IDSCETHZurich/klask_hardware/docs/tutorials/00-overview.md

# Tutorial Overview

There are several tutorials available to help you get started with KLASK Hardware. These tutorials cover various aspects of working with the hardware, from setting up your environment to advanced usage scenarios.

## Available Tutorials

- [Hardware Assembly Guide](01-hardware-assembly.md): Step-by-step instructions to assemble the KLASK hardware components.
- [Runtime Startup](02-runtime-startup.md): Guide to starting up and shutting down the KLASK hardware safely.
- [Development Setup](03-dev-setup.md): Instructions for setting up your development environment for working with KLASK Hardware.
