IDSCETHZurich/klask_hardware/(list of files, cad)

Other CAD files:
hardware/cad/assemblies/board_frame.SLDASM
hardware/cad/third_party_parts/assemblies/mini v gantry kit.SLDASM
hardware/cad/assemblies/frame_support.SLDASM
hardware/cad/klask_game_board/KlaskGame.SLDASM
hardware/cad/third_party_parts/assemblies/idler.SLDASM
hardware/cad/assemblies/global_assembly.SLDASM
hardware/cad/assemblies/gantry.SLDASM
hardware/cad/assemblies/bridge.SLDASM
hardware/cad/assemblies/controller_base_passive.SLDASM
hardware/cad/assemblies/limit_switch.SLDASM
hardware/cad/assemblies/duality_connector.SLDASM
hardware/cad/assemblies/foot_assembly.SLDASM
hardware/cad/assemblies/belt_attachment.SLDASM
hardware/cad/assemblies/motor_assembly.SLDASM
hardware/cad/assemblies/camera_mount.SLDASM
hardware/cad/assemblies/gantry_frame.SLDASM
hardware/cad/assemblies/idler_assembly.SLDASM
hardware/cad/assemblies/stepper_mount.SLDASM
hardware/cad/klask_game_board/KlaskScoreCoin.SLDPRT
hardware/cad/parts/goal_disk_flat.SLDPRT
hardware/cad/third_party_parts/parts/bearings/Ball Bearing 5 x 16 x 5.SLDPRT
hardware/cad/third_party_parts/parts/brackets/Black Angle Corner Connector.SLDPRT
hardware/cad/third_party_parts/parts/electronics/M8325s_S1.SLDPRT
hardware/cad/third_party_parts/parts/mini_v_gantry_kit/Precision Shim 8 x 5 x 1.SLDPRT
hardware/cad/third_party_parts/parts/plates/Joining Plate Cross.step.SLDPRT
hardware/cad/third_party_parts/parts/profiles/V-Slot-20x20-Cover.SLDPRT
hardware/cad/third_party_parts/parts/pulleys/Smooth Idler Pulley Wheel.step.SLDPRT
hardware/cad/third_party_parts/parts/shims_spacers/Aluminum Spacer 9mm.step.SLDPRT
hardware/cad/parts/board_corner.SLDPRT
hardware/cad/third_party_parts/parts/brackets/L Bracket Single.SLDPRT
hardware/cad/third_party_parts/parts/electronics/Nanlite_compac_24B.SLDPRT
hardware/cad/third_party_parts/parts/mini_v_gantry_kit/Ball Bearing 5 x 10 x 4.2.step.SLDPRT
hardware/cad/third_party_parts/parts/plates/Joining Strip Plate 2 Hole.step.SLDPRT
hardware/cad/third_party_parts/parts/profiles/V-Slot 20x20 Linear Rail.SLDPRT
hardware/cad/third_party_parts/parts/pulleys/GT2 Timing Pulley 20 Tooth.step.SLDPRT
hardware/cad/third_party_parts/parts/shims_spacers/Aluminum Spacer 6mm.SLDPRT
hardware/cad/klask_game_board/KlaskControllerBase.SLDPRT
hardware/cad/parts/goal_disk_sphere.SLDPRT
hardware/cad/third_party_parts/parts/brackets/Inside Hidden Corner Bracket.SLDPRT
hardware/cad/third_party_parts/parts/electronics/nema 17 42-34.SLDPRT
hardware/cad/third_party_parts/parts/mini_v_gantry_kit/Mini V Wheel Plate.SLDPRT
hardware/cad/third_party_parts/parts/plates/Idler Pulley Plate.SLDPRT
hardware/cad/third_party_parts/parts/shims_spacers/Aluminum Spacer 3mm.step.SLDPRT
hardware/cad/klask_game_board/KlaskBall.SLDPRT
hardware/cad/parts/frame_centering_bridge.SLDPRT
hardware/cad/third_party_parts/parts/brackets/End Cap.step.SLDPRT
hardware/cad/third_party_parts/parts/electronics/camera.SLDPRT
hardware/cad/third_party_parts/parts/plates/Motor Mount Plate Nema 17.step.SLDPRT
hardware/cad/third_party_parts/parts/shims_spacers/Precision Shim 10 x 5 x 1.step.SLDPRT
hardware/cad/klask_game_board/KlaskBiscuit.SLDPRT
hardware/cad/parts/frame_support_center_plate.SLDPRT
hardware/cad/third_party_parts/parts/brackets/Cube Corner Connector.step.SLDPRT
hardware/cad/third_party_parts/parts/electronics/WE_LimitSwitch_463093370402.SLDPRT
hardware/cad/klask_game_board/Klask.SLDPRT
hardware/cad/parts/frame_support_groundplate.SLDPRT
hardware/cad/third_party_parts/parts/mini_v_gantry_kit/Eccentric Spacer 6mm v1.SLDPRT
hardware/cad/klask_game_board/KlaskControllerTop.SLDPRT
hardware/cad/parts/frame_support_mounting.SLDPRT
hardware/cad/third_party_parts/parts/mini_v_gantry_kit/Delrin Mini V Wheel.SLDPRT
hardware/cad/parts/peg_holder_v3.SLDPRT
hardware/cad/parts/limit_switch_mount.SLDPRT
hardware/cad/parts/limit_switch_cover.SLDPRT
hardware/cad/parts/belt_adaptive.SLDPRT
hardware/cad/parts/Motor_enclosure_bottom.SLDPRT
hardware/cad/parts/Connector.SLDPRT
hardware/cad/parts/Shaft.SLDPRT
hardware/cad/parts/Motor_enclosure_top.SLDPRT
hardware/cad/parts/belt.SLDPRT
hardware/cad/parts/rubber_feet.SLDPRT
hardware/cad/parts/pipe_clamp.SLDPRT
hardware/cad/parts/peg_holder.SLDPRT
hardware/cad/third_party_parts/parts/mini_v_gantry_kit/Low Profile Screw M5 v1.SLDPRT
hardware/cad/third_party_parts/parts/mini_v_gantry_kit/Nylon Insert Lock Nut M5.SLDPRT
hardware/cad/third_party_parts/parts/nuts/BN_629_1241613_nut_M3.sldprt
hardware/cad/third_party_parts/parts/nuts/BN_629_1348418_Nut_M2.sldprt
hardware/cad/third_party_parts/parts/nuts/Double Tee Nut.SLDPRT
hardware/cad/third_party_parts/parts/nuts/Hex_Nut_M5.sldprt
hardware/cad/third_party_parts/parts/nuts/Tee Nut.step.SLDPRT
hardware/cad/third_party_parts/parts/screws/BN_4719_1099876_M2x12.sldprt
hardware/cad/third_party_parts/parts/screws/BN_4719_1100114_M3x25.sldprt
hardware/cad/third_party_parts/parts/screws/BN_4719_1713736_M5x18.sldprt
hardware/cad/third_party_parts/parts/screws/BN_610_1420607_M2x12.sldprt
hardware/cad/third_party_parts/parts/screws/BN_610_3092533_M5x30.sldprt
hardware/cad/third_party_parts/parts/screws/Countersunk_Screw_M3x14.sldprt
hardware/cad/third_party_parts/parts/screws/Low Profile Screw M5.step.SLDPRT
hardware/cad/third_party_parts/parts/screws/Low Profile Screw M5x25.SLDPRT
hardware/cad/third_party_parts/parts/screws/Low Profile Screw M5x30.SLDPRT
hardware/cad/third_party_parts/parts/screws/Low Profile Screw M5x35.SLDPRT
hardware/cad/third_party_parts/parts/screws/Self Tapping Screw.step.SLDPRT
hardware/cad/third_party_parts/parts/screws/Zyl-Schr-M4x20.sldprt
hardware/cad/third_party_parts/parts/screws/Zyl-Schr-M5x14.SLDPRT
hardware/cad/third_party_parts/parts/screws/Zyl-Schr-M5x20.SLDPRT
hardware/cad/third_party_parts/parts/shims_spacers/Slot Washer 15 x 5 x 2.step.SLDPRT
