IDSCETHZurich/klask_hardware/(commit log)

2025-12-03 chore(estimator): workspace mounted in container for persistence
2025-12-03 feat(motor): motor_commander package created
2025-12-05 feat(motor): motor node migrated
2025-12-05 feat(motor): launch file improved
2025-12-05 docs: motor launch command example added
2025-12-05 bug(motor): motor launch file condition bug fixed
    [motors_launch.py]
2025-12-05 chore(estimator): Kalman filter class and helper functions refactored by claude
2025-12-05 feat(estimator): update rate of image throttled
2025-12-06 chore(motor): code cleanup by claude
2025-12-08 feat(estimator): flood fill for board corner detection added
2025-12-08 feat(estimator): rotated rectangular board detection added
2025-12-08 feat(estimator): boarder segmentation started
2025-12-09 chore(camera): camera node formatted and old print functionallity readded
2025-12-09 feat(camera): boarder segment mask finished
2025-12-09 feat(camera): line seeded flood fill of boarder segments added
2025-12-09 feat(camera): segment transformation started
2025-12-10 feat(camera): segment rotation and debug image loading added
2025-12-10 feat(camera): boarder point detection and line fitting finished
2025-12-10 chore(camera): methods refactored for frame_process call
2025-12-10 chore(camera): debug functionality moved to own file
2025-12-11 chore(camera): unused methods removed and static computation data refactored
2025-12-11 feat(camera): add image display functionality with FPS overlay
2025-12-11 feat(camera): enhance border detection with smoothing and update debug display functions
2025-12-11 feat(camera): implement one-shot timer for profiling and update stats printing
2025-12-11 refactor(camera): improve perspective transform handling and simplify width/height calculations
2025-12-11 feat(camera): implement outlier detection for border tracking
2025-12-11 feat(camera): add goal detection logic and enhance debug visualization for goal positions
2025-12-12 chore(CAD): repo prepared for CAD files
2025-12-12 chore(camera): removed unused files and small cleanup
2025-12-13 feat(state): updated state estimator to publish proper board state
2025-12-14 feat(state): update state representation to use UInt64 and add BoardState class for goal tracking
2025-12-14 feat(camera): moved node configuration to ros parameters and added config guide
2025-12-14 chore(camera): streamline camera node parameters and improve documentation clarity
2025-12-14 feat(camera): enhance camera node parameters and improve calibration file handling
2025-12-14 feat(image_viewer): add parameter for board image topic
2025-12-16 feat(cad): game board and frame added
    [Klask.SLDPRT, KlaskBall.SLDPRT, KlaskBiscuit.SLDPRT, KlaskControllerBase.SLDPRT, KlaskControllerTop.SLDPRT, KlaskGame.SLDASM, KlaskScoreCoin.SLDPRT, V-Slot 20x20 Linear Rail.SLDPRT]
2025-12-16 feat(cad): gantry_frame and bridge assembly files added
    [V-Slot 20x20 Linear Rail.SLDPRT, bridge.SLDASM, gantry_frame.SLDASM, global_assembly.SLDASM]
2025-12-16 chore(motor): motor controller package renamed to match convention
2025-12-16 feat(odrive): update state subscription and callback to use new State message format
2025-12-17 bug(motor): motor message QoS corrected and shutdown sequence improved
    [player.cpp]
2025-12-17 feat(motor): refactor player handling to distinguish between left and right players
2025-12-17 feat(motor): add teleop twist keyboard package to Dockerfile
2025-12-17 feat(motor): add teleop launch configuration for player control
2025-12-17 feat(motor): enhance launch configurations and add start_commander parameter for motor commander control
2025-12-17 fix(player): improve synchronization checks in is_synchronized method
    [player.cpp]
2025-12-22 feat(config): update camera node parameters for improved tracking accuracy
2025-12-22 feat(motor): add xterm support for teleop twist keyboard and update default player configuration
2025-12-22 refactor(motor): motor commander refactored to match the latest version
2025-12-22 feat(motor): Enhance motor controller functionality with new services and action for peg homing
2025-12-22 bug(motor): boundary check corrected
    [open_loop_controller.hpp, player.cpp]
2025-12-28 chore: bridge migration started
    [Aluminum Spacer 6mm.SLDPRT, Aluminum Spacer 6mm.step, Ball Bearing 5 x 10 x 4.2.step.SLDPRT, Delrin Mini V Wheel.SLDPRT, Eccentric Spacer 6mm v1.SLDPRT, Low Profile Screw M5 v1.SLDPRT, Mini V Wheel Plate.SLDPRT, Nylon Insert Lock Nut M5.SLDPRT]
2025-12-29 chore: bridge migration finished
    [Aluminum Spacer 3mm.step.SLDPRT, Aluminum Spacer 6mm.SLDPRT, Aluminum Spacer 6mm.step, Aluminum Spacer 9mm.step.SLDPRT, Ball Bearing 5 x 16 x 5.SLDPRT, Black Angle Corner Connector.SLDPRT, Double Tee Nut.SLDPRT, End Cap.step.SLDPRT]
2025-12-29 chore: gantry frame migrated
    [Cube Corner Connector.step.SLDPRT, GT2 Timing Pulley 20 Tooth.step.SLDPRT, Idler Pulley Plate.SLDPRT, Inside Hidden Corner Bracket.SLDPRT, Joining Strip Plate 2 Hole.step.SLDPRT, Motor Mount Plate Nema 17.step.SLDPRT, V-Slot 20x20 Linear Rail.SLDPRT, belt.SLDPRT]
2025-12-29 chore: gantry migration finished
    [V-Slot 20x20 Linear Rail.SLDPRT, belt_adaptive.SLDPRT, board_frame.SLDASM, duality_connector.SLDASM, gantry.SLDASM, global_assembly.SLDASM]
2025-12-30 chore: motors and peg holder updated
    [Connector.SLDPRT, M8325s_S1.SLDPRT, Motor_enclosure_bottom.SLDPRT, Motor_enclosure_top.SLDPRT, Shaft.SLDPRT, bridge.SLDASM, controller_base_passive.SLDASM, gantry.SLDASM]
2025-12-31 feat(controller): migrate open loop controller parameters to YAML configuration and update parameter handling
    [open_loop_controller_params.yaml]
2025-12-31 feat(motor): migrate motor commander and ODrive parameters to YAML configuration and update parameter handling
    [motor_commander_params.yaml, odrive_controller_params.yaml]
2025-12-31 feat(controller): migrate player configuration to use PlayerSide enum and handle sides more generic
    [motor_commander_params.yaml]
2025-12-31 feat(state_estimator): implement pixel to engineering units conversion for state estimate
    [open_loop_controller_params.yaml]
2025-12-31 chore: file formatted
    [open_loop_controller_params.yaml]
2026-01-01 chore: limit switch mount added
    [WE_LimitSwitch_463093370402.SLDPRT, gantry.SLDASM, gantry_frame.SLDASM, limit_switch.SLDASM, limit_switch_cover.SLDPRT, limit_switch_mount.SLDPRT]
2026-01-01 chore: mirrored limit switch added
    [gantry.SLDASM, global_assembly.SLDASM, limit_switch.SLDASM, limit_switch_cover.SLDPRT, limit_switch_mount.SLDPRT]
2026-01-02 chore: frame mount added
    [board_frame.SLDASM, frame_centering_bridge.SLDPRT, frame_support.SLDASM, frame_support_center_plate.SLDPRT, frame_support_groundplate.SLDPRT, frame_support_mounting.SLDPRT, gantry.SLDASM, global_assembly.SLDASM]
2026-01-02 chore: camera mount added
    [Connector.SLDPRT, Motor_enclosure_bottom.SLDPRT, Motor_enclosure_top.SLDPRT, Nanlite_compac_24B.SLDPRT, V-Slot-20x20-Cover.SLDPRT, camera.SLDPRT, camera_mount.SLDASM, frame_centering_bridge.SLDPRT]
2026-01-02 feat: new peg holder designed
    [board_frame.SLDASM, bridge.SLDASM, controller_base_passive.SLDASM, frame_support.SLDASM, gantry.SLDASM, gantry_frame.SLDASM, global_assembly.SLDASM, motor_assembly.SLDASM]
2026-01-03 docs(hw assembly): instructions uploaded as found on Notion
2026-01-03 docs(hw assembly): updated instruction with additional information from Carlos report
2026-01-03 docs: added BOM for additional components
2026-01-05 chore: limit switch assembly fastening elements added
    [BN_4719_1099876_M2x12.sldprt, BN_4719_1713736_M5x18.sldprt, BN_629_1348418_Nut_M2.sldprt, bridge.SLDASM, controller_base_passive.SLDASM, gantry.SLDASM, global_assembly.SLDASM, limit_switch.SLDASM]
2026-01-05 feat(camera): image viewer launch file added and camaer parameters adapted
2026-01-05 fix(motor_commander): remove duplicated calibration service parameter
    [motor_commander_params.yaml]
2026-01-05 feat(motro): open loop controller and homing improved
    [motor_commander_params.yaml, odrive_controller_params.yaml, open_loop_controller_params.yaml]
2026-01-05 feat(open_loop_controller): add movement validation parameters and logic
    [open_loop_controller_params.yaml]
2026-01-07 chore(motors): parameter adjustments
    [open_loop_controller_params.yaml]
2026-01-11 feat(odrive_controller): add external cmd_vel command control during homing and calibration
2026-01-11 feat(calibration): add GetCalibrationStatus service and related functionality
    [odrive_controller_params.yaml]
2026-01-11 feat(home_calibration): add HomeAndCalibrate service and integrate into motor commander
    [odrive_controller_params.yaml]
2026-01-11 feat(image_viewer): add status overlay functionality and moved BoardState enum to interface
2026-01-12 feat(motors_launch): add camera and image viewer launch options
2026-01-12 chore: python files formatted and linter warnings fixed
    [motors_launch.py]
2026-01-12 chore: yaml files formatted
    [motor_commander_params.yaml, odrive_controller_params.yaml]
2026-01-13 chore: fastening elements to board frame added
    [board_frame.SLDASM, frame_centering_bridge.SLDPRT]
2026-01-13 chore: fastening elements to camera frame added
    [camera_mount.SLDASM]
2026-01-13 chore: remaining fastening elements added
    [BN_4719_1100114_M3x25.sldprt, BN_610_1420607_M2x12.sldprt, BN_610_3092533_M5x30.sldprt, BN_629_1241613_nut_M3.sldprt, BN_629_1348418_Nut_M2.sldprt, Double Tee Nut.SLDPRT, Tee Nut.step.SLDPRT, Zyl-Schr-M4x20.sldprt]
2026-01-14 docs: instructions for board frame and camera mount added
2026-01-14 docs: controller assembly documentation added
2026-01-14 docs: assembly instructions for the bridge, the frame mount and the limit switch mount added
2026-01-14 chore: explosion views to assemblies added
    [Low Profile Screw M5x25.SLDPRT, Low Profile Screw M5x30.SLDPRT, Low Profile Screw M5x35.SLDPRT, Tee Nut.step.SLDPRT, belt_attachment.SLDASM, board_frame.SLDASM, bridge.SLDASM, camera_mount.SLDASM]
2026-01-14 chore: gantry explosion views added
    [Low Profile Screw M5x25.SLDPRT, Low Profile Screw M5x35.SLDPRT, bridge.SLDASM, gantry.SLDASM, gantry_frame.SLDASM, limit_switch.SLDASM, motor_assembly.SLDASM]
2026-01-14 docs: gantry assembly instructions updated
2026-01-14 docs: overall BOM added
2026-01-15 feat: add IsPlayerHomed service and update homing parameters
    [odrive_controller_params.yaml, open_loop_controller_params.yaml]
2026-01-15 fix: clang format applied
    [open_loop_controller.cpp]
2026-01-15 feat(motor): home and calibrate refactored from service to action
    [odrive_controller_params.yaml]
2026-01-16 fix: duplicated parameters removed
    [motor_commander_params.yaml]
2026-01-16 docs: image added to doc landing page
2026-01-16 fix: update calibration services and improve player-specific handling
    [odrive_controller.cpp, odrive_controller.hpp]
2026-01-16 fix: streamline homing process by consolidating player handling and removing redundant structures
    [odrive_controller.cpp]
2026-01-16 fix: enhance homing sequence to execute actions in parallel and improve error handling
    [klask_motor_commander.cpp]
2026-01-16 chore: update home position parameters for right and left players
    [odrive_controller_params.yaml]
2026-01-27 feat: mounting extrude of frame support improved
    [Countersunk_Screw_M3x14.sldprt, frame_support.SLDASM, frame_support_groundplate.SLDPRT, gantry.SLDASM, global_assembly.SLDASM]
2026-02-04 feat: magnet hole depth increased of peg holder
    [peg_holder_v3.SLDPRT]
2026-02-04 fix: update player parameters for improved motion control and safety margins
    [player.cpp, player_params.yaml]
2026-02-04 chore: peg holder offset improved
    [peg_holder_v3.SLDPRT]
2026-02-06 fix: adjust flood fill threshold and update motor parameters for improved performance
    [camera_node_params.yaml, player_params.yaml]
2026-02-06 fix: update field boundary parameters
    [player_params.yaml]
2026-02-08 chore: controller base updated
    [bridge.SLDASM, controller_base_passive.SLDASM, gantry.SLDASM, global_assembly.SLDASM]
2026-02-17 fix: video device index reset
2026-02-17 docs: old partion BOM removed
2026-02-26 feat: frame support updated
    [Hex_Nut_M5.sldprt, Zyl-Schr-M5x14.SLDPRT, Zyl-Schr-M5x20.SLDPRT, board_frame.SLDASM, frame_centering_bridge.SLDPRT, frame_support.SLDASM, frame_support_center_plate.SLDPRT, frame_support_groundplate.SLDPRT]
2026-03-30 feat: add heartbeat publisher and parameters to ODriveController
    [odrive_controller_params.yaml]
2026-03-30 feat: implement fatal error handling for motor errors and update heartbeat topic
    [odrive_controller_params.yaml]
2026-03-31 chore: correct formatter for player.cpp applied
    [player.cpp]
2026-04-13 chore: linter and formatter warnings fixed
    [teleop_launch.py]
2026-04-13 feat: add boundary deceleration enabling service
    [odrive_controller_params.yaml]
2026-04-13 feat: add velocity profile node and launch configuration
2026-04-17 fix: corrected ODrive control and input modes for improved command handling
    [player.cpp, player.hpp]
2026-05-05 fix: unnecessary opencv dependency removed and odrive relocated to merged upstream repo
2026-06-03 feat: goal discs added and frame support explosion view updated
    [board_corner.SLDPRT, board_frame.SLDASM, frame_support.SLDASM, goal_disk_flat.SLDPRT, goal_disk_sphere.SLDPRT]
